TotoNonn/CNC-machine-PCB-desing/README.md

# About project
I'm 700mV. I made this to try to help and to try to understand what happens in a cnc machine when you do all the parts. I started this project when I was in the university. The principal rason to do this is to do PCBs in house, for dont buy something than I can do it. The way is hard because I dont reach the same presition in a handmade machine that the presition in a really good machine made by a manufacturer or made whit super tools.
But is that the challenge, reach that.

## Objetive
Make a CNC machine whit my own tools, learn about everything that I can and help people like me.

Free tools for everyone.

-700mV
