TotoNonn/CNC-machine-PCB-desing/Hardware/Design/PCB-DRV/PCB-DRV.kicad_pcb

## KiCad design Hardware/Design/PCB-DRV/PCB-DRV.kicad_pcb (2026-10-14)

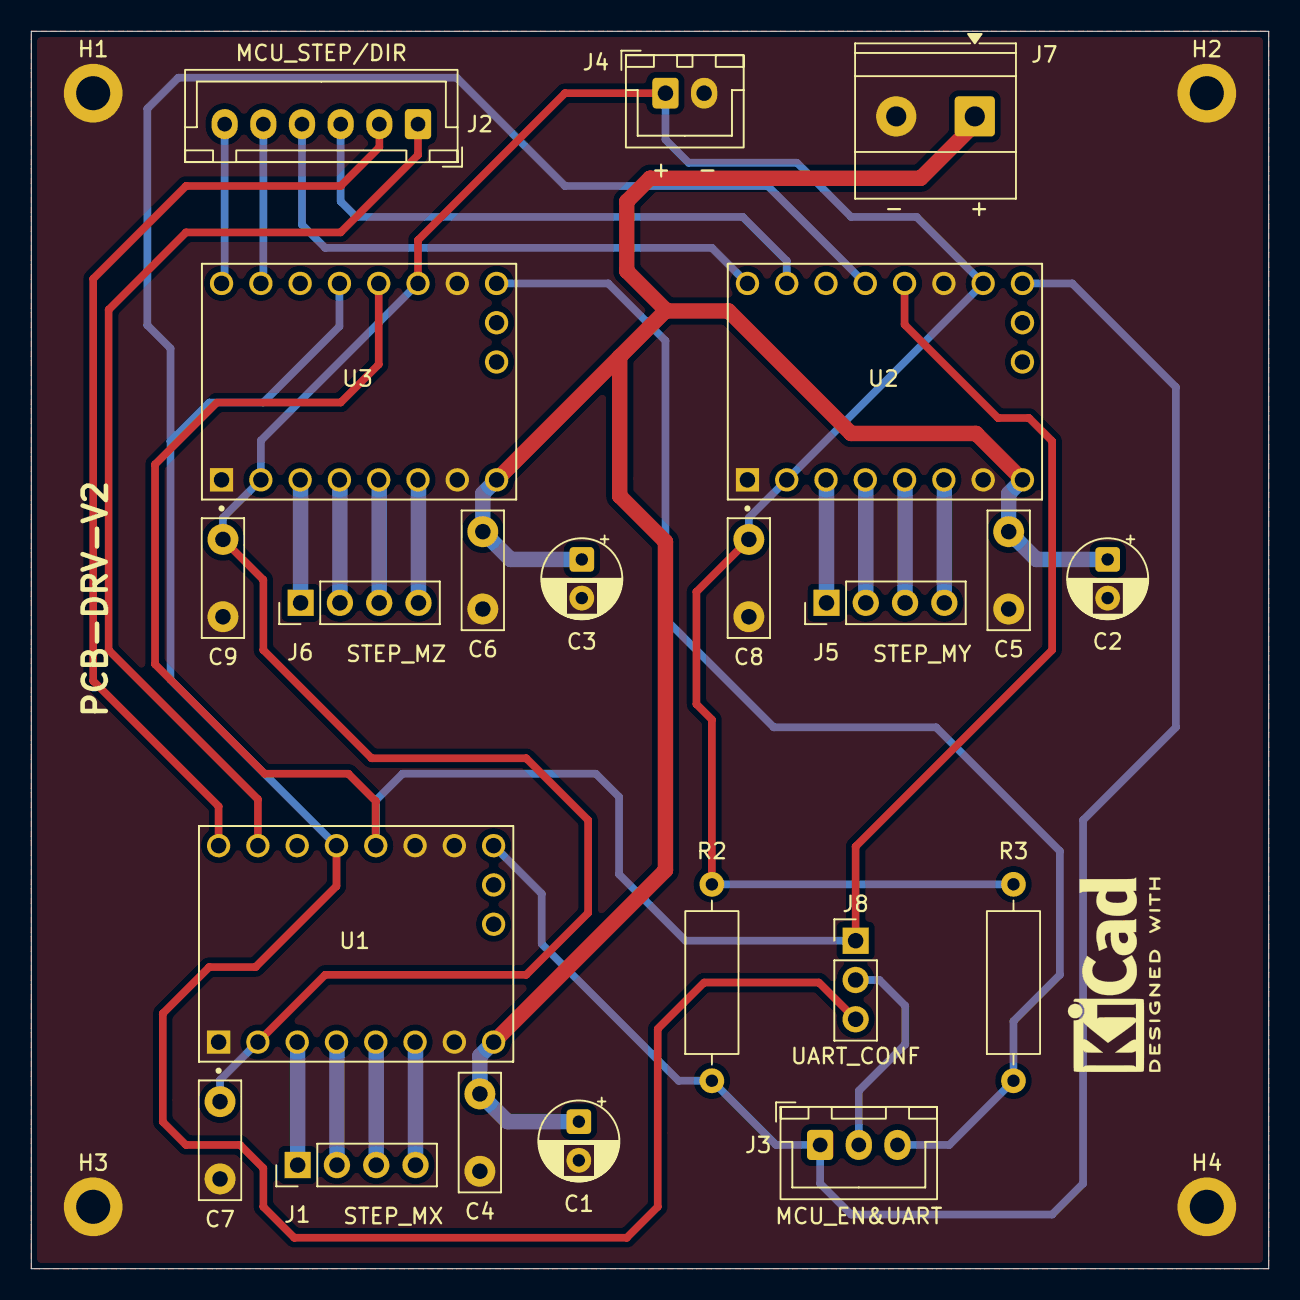
[picture p1: board PCB-DRV.kicad_pcb from above]

Board: 2 copper layers, 80.0 x 80.0 mm, 26 parts (0 on the bottom side), 26 nets.

Parts:
C1, C2, C3: 100uF; CP_Radial_D5.0mm_P2.50mm
C4, C5, C6, C7, C8, C9: 100nF; C_Disc_D7.5mm_W2.5mm_P5.00mm
H1, H2, H3, H4: MountingHole_2.2mm_M2_DIN965_Pad
J1: STEP_MX; PinHeader_1x04_P2.54mm_Vertical
J2: MCU_STEP/DIR; JST_XH_B6B-XH-A_1x06_P2.50mm_Vertical
J3: MCU_EN&UART; JST_XH_B3B-XH-A_1x03_P2.50mm_Vertical
J4: +3.3V; JST_XH_B2B-XH-A_1x02_P2.50mm_Vertical
J5: STEP_MY; PinHeader_1x04_P2.54mm_Vertical
J6: STEP_MZ; PinHeader_1x04_P2.54mm_Vertical
J7: +12V; TerminalBlock_Phoenix_MKDS-1,5-2-5.08_1x02_P5.08mm_Horizont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
J8: UART_CONF; PinHeader_1x03_P2.54mm_Vertical
R2, R3: 10K; R_Axial_DIN0309_L9.0mm_D3.2mm_P12.70mm_Horizontal
U1, U2, U3: TMC2209_SILENTSTEPSTICK; MODULE_TMC2209_SILENTSTEPSTICK

Connections:
+3.3V: C7.1, C8.1, C9.1, J4.1, R2.2, R3.2, U1.2 (VIO), U2.2 (VIO), U2.15 (MS1), U3.2 (VIO), U3.14 (MS2)
+12V: C1.1, C2.1, C3.1, C4.1, C5.1, C6.1, J7.1, U1.8 (VM), U2.8 (VM), U3.8 (VM)
Ax1: J1.2, U1.4 (M1A)
Ax2: J1.1, U1.3 (M1B)
Ay1: J5.2, U2.4 (M1A)
Ay2: J5.1, U2.3 (M1B)
Az1: J6.2, U3.4 (M1A)
Az2: J6.1, U3.3 (M1B)
Bx1: J1.3, U1.5 (M2A)
Bx2: J1.4, U1.6 (M2B)
By1: J5.3, U2.5 (M2A)
By2: J5.4, U2.6 (M2B)
Bz1: J6.3, U3.5 (M2A)
Bz2: J6.4, U3.6 (M2B)
GND: C1.2, C2.2, C3.2, C4.2, C5.2, C6.2, C7.2, C8.2, C9.2, H1.1, H2.2, H3.3, H4.4, J4.2, J7.2, U1.1 (GND), U1.7 (GND), U1.14 (MS2), U1.15 (MS1), U2.1 (GND), U2.7 (GND), U2.14 (MS2), U3.1 (GND), U3.7 (GND), U3.15 (MS1)
GPIO_DIR_1: J2.2, U1.9 (DIR)
GPIO_DIR_2: J2.4, U2.9 (DIR)
GPIO_DIR_3: J2.6, U3.9 (DIR)
GPIO_EN_XY: J3.1, R2.1, U1.16 (~EN), U2.16 (~EN)
GPIO_EN_Z: J3.3, R3.1, U3.16 (~EN)
GPIO_STEP_1: J2.1, U1.10 (STEP)
GPIO_STEP_2: J2.3, U2.10 (STEP)
GPIO_STEP_3: J2.5, U3.10 (STEP)
GPIO_UART: J3.2, J8.2
GPIO_UART_SLNK: J8.3, U1.12 (UART), U2.12 (UART), U3.12 (UART)
GPIO_UART_V985: J8.1, U1.13 (SPRD), U2.13 (SPRD), U3.13 (SPRD)
