TotoNonn/CNC-machine-PCB-desing/Hardware/Design/PCB-HUS/PCB-HUS.kicad_pcb

## KiCad design Hardware/Design/PCB-HUS/PCB-HUS.kicad_pcb (2026-08-30)

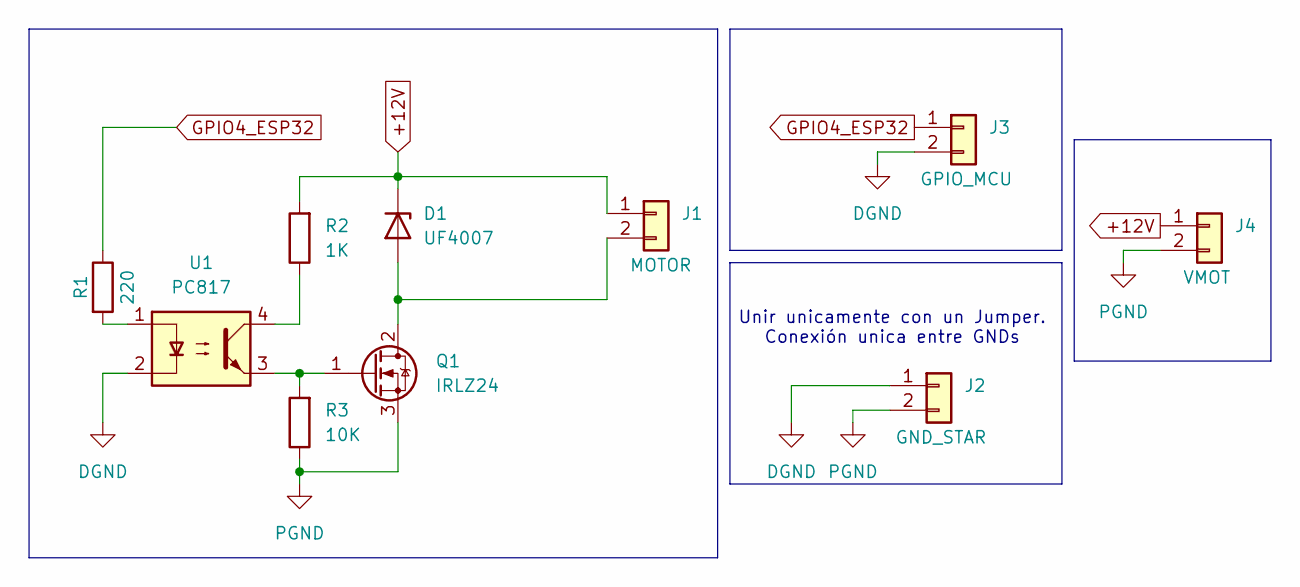
[picture p2: schematic PCB-HUS.kicad_sch]

Parts:
D1: UF4007; D_DO-41_SOD81_P10.16mm_Horizontal
J1: MOTOR; TerminalBlock_Phoenix_MKDS-1,5-2-5.08_1x02_P5.08mm_Horizont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
J2: GND_STAR; PinHeader_1x02_P2.54mm_Vertical
J3: GPIO_MCU; JST_XH_B2B-XH-A_1x02_P2.50mm_Vertical
J4: VMOT; TerminalBlock_Phoenix_MKDS-1,5-2-5.08_1x02_P5.08mm_Horizont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
Q1: IRLZ24; TO-220-3_Vertical
R1: 220; R_Axial_DIN0309_L9.0mm_D3.2mm_P12.70mm_Horizontal
R2: 1K; R_Axial_DIN0309_L9.0mm_D3.2mm_P12.70mm_Horizontal
R3: 10K; R_Axial_DIN0309_L9.0mm_D3.2mm_P12.70mm_Horizontal
U1: PC817; DIP-4_W7.62mm

Connections:
+12V: D1.1 (K), J1.1, J4.1, R2.2
DGND: J2.1, J3.2, U1.2
GPIO4_ESP32: J3.1, R1.1
unnamed: D1.2 (A), J1.2, Q1.2 (D)
unnamed: Q1.1 (G), R3.2, U1.3
unnamed: R1.2, U1.1
unnamed: R2.1, U1.4
PGND: J2.2, J4.2, Q1.3 (S), R3.1

Notes on the sheet:
Unir unicamente con un Jumper. Conexión unica entre GNDs

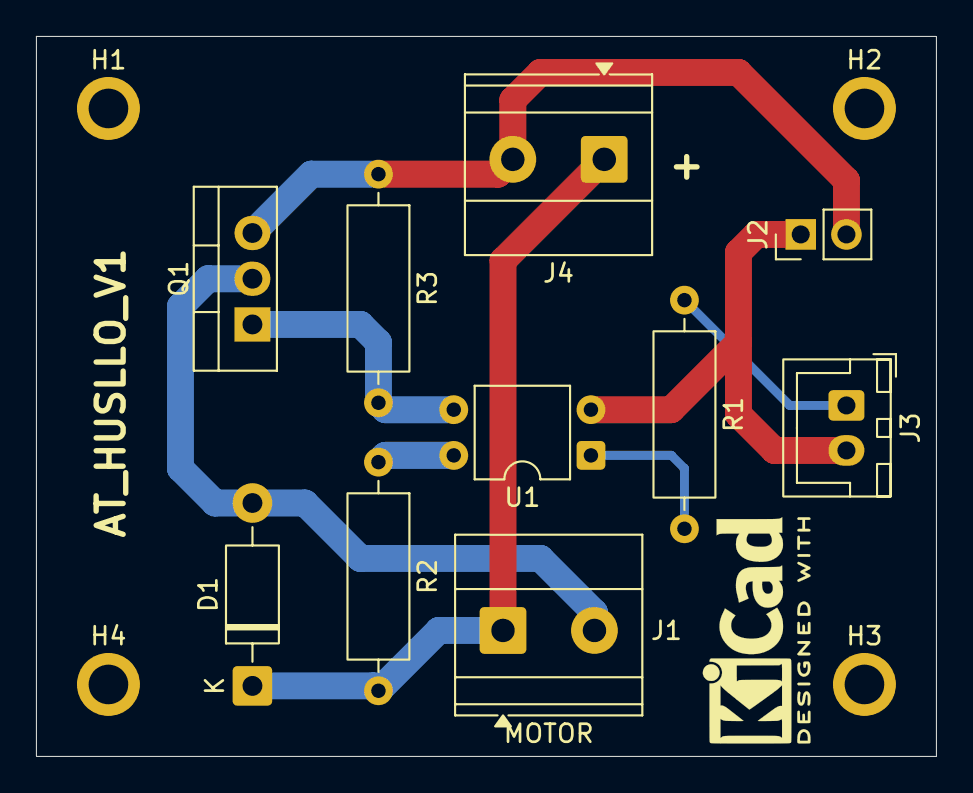
[picture p3: board PCB-HUS.kicad_pcb from above]

Board: 2 copper layers, 50.0 x 40.0 mm, 14 parts (0 on the bottom side), 8 nets.

Other parts of the board:
H1, H2, H3, H4: MountingHole_2.2mm_M2_ISO7380_Pad
