TotoNonn/CNC-machine-PCB-desing/Hardware/Design/PCB-END/PCB-END.kicad_pcb

## KiCad design Hardware/Design/PCB-END/PCB-END.kicad_pcb (2026-08-30)

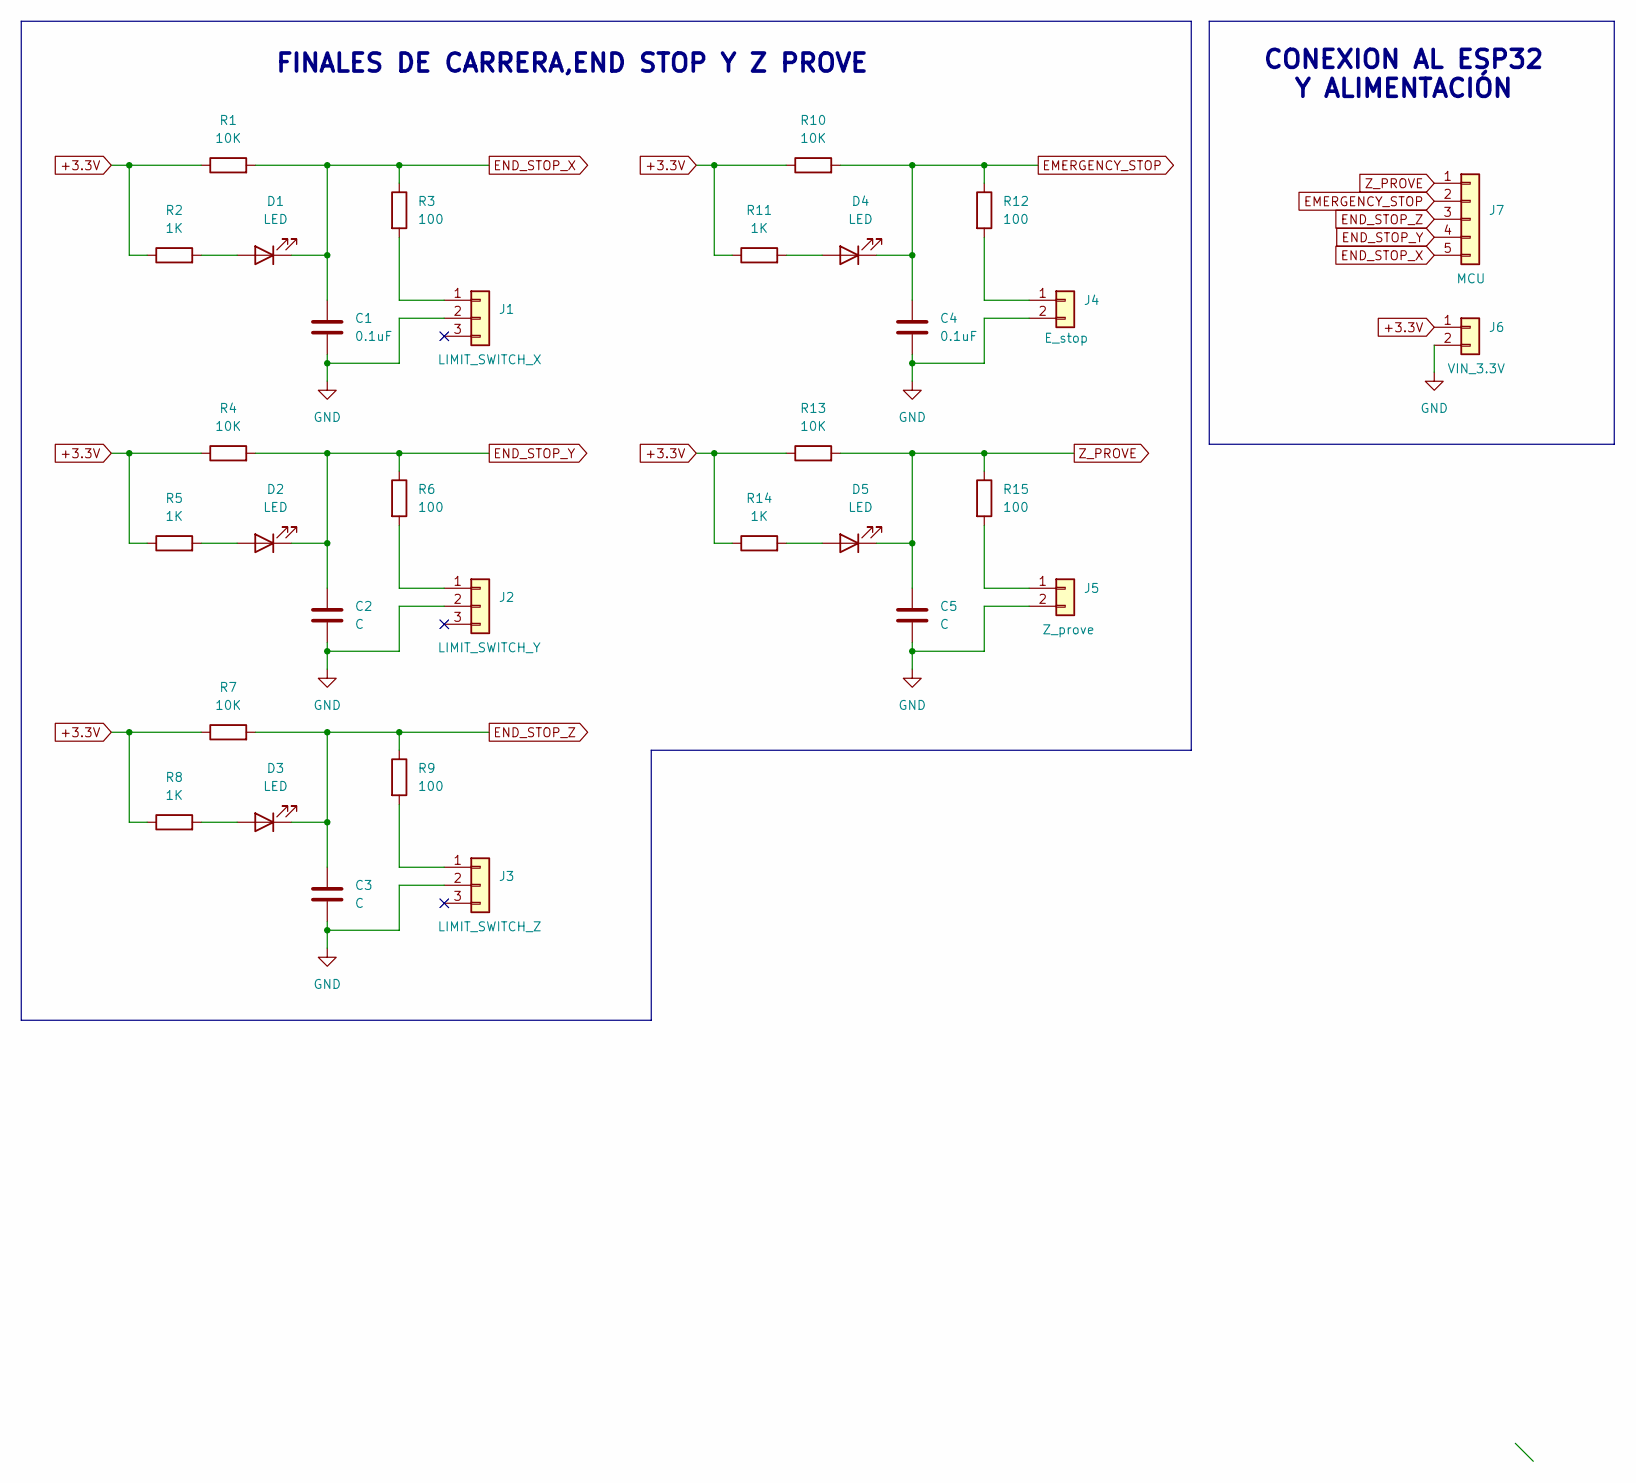
[picture p4: schematic PCB-END.kicad_sch]

Parts:
C1, C4: 0.1uF; C_Disc_D4.3mm_W1.9mm_P5.00mm
C2, C3, C5: C; C_Disc_D4.3mm_W1.9mm_P5.00mm
D1, D2, D3, D4, D5: LED; LED_D3.0mm
J1: LIMIT_SWITCH_X; JST_XH_B3B-XH-A_1x03_P2.50mm_Vertical
J2: LIMIT_SWITCH_Y; JST_XH_B3B-XH-A_1x03_P2.50mm_Vertical
J3: LIMIT_SWITCH_Z; JST_XH_B3B-XH-A_1x03_P2.50mm_Vertical
J4: E_stop; JST_XH_B2B-XH-A_1x02_P2.50mm_Vertical
J5: Z_prove; JST_XH_B2B-XH-A_1x02_P2.50mm_Vertical
J6: VIN_3.3V; JST_XH_B2B-XH-A_1x02_P2.50mm_Vertical
J7: MCU; JST_XH_B5B-XH-A_1x05_P2.50mm_Vertical
R1, R4, R7, R10, R13: 10K; R_Axial_DIN0309_L9.0mm_D3.2mm_P12.70mm_Horizontal
R2, R5, R8, R11, R14: 1K; R_Axial_DIN0309_L9.0mm_D3.2mm_P12.70mm_Horizontal
R3, R6, R9, R12, R15: 100; R_Axial_DIN0309_L9.0mm_D3.2mm_P12.70mm_Horizontal

Connections:
+3.3V: J6.1, R1.1, R2.1, R4.1, R5.1, R7.1, R8.1, R10.1, R11.1, R13.1, R14.1
EMERGENCY_STOP: C4.1, D4.1 (K), J7.2, R10.2, R12.1
END_STOP_X: C1.1, D1.1 (K), J7.5, R1.2, R3.1
END_STOP_Y: C2.1, D2.1 (K), J7.4, R4.2, R6.1
END_STOP_Z: C3.1, D3.1 (K), J7.3, R7.2, R9.1
GND: C1.2, C2.2, C3.2, C4.2, C5.2, J1.2, J2.2, J3.2, J4.2, J5.2, J6.2; also elsewhere on the board
unnamed: D1.2 (A), R2.2
unnamed: D2.2 (A), R5.2
unnamed: D3.2 (A), R8.2
unnamed: D4.2 (A), R11.2
unnamed: D5.2 (A), R14.2
unnamed: J1.1, R3.2
unnamed: J2.1, R6.2
unnamed: J3.1, R9.2
unnamed: J4.1, R12.2
unnamed: J5.1, R15.2
Z_PROVE: C5.1, D5.1 (K), J7.1, R13.2, R15.1

Notes on the sheet:
CONEXION AL ESP32 Y ALIMENTACIÓN
FINALES DE CARRERA,END STOP Y Z PROVE

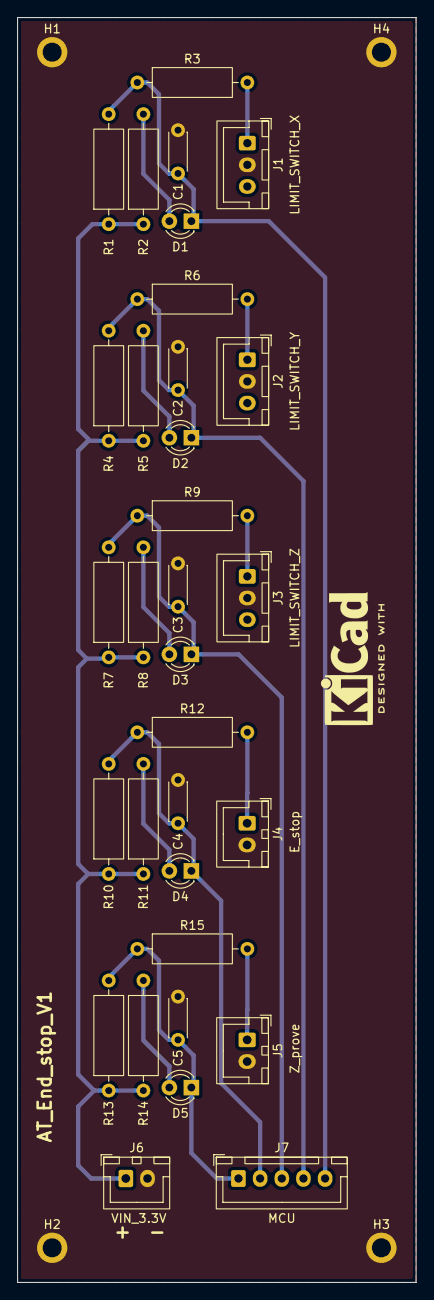
[picture p5: board PCB-END.kicad_pcb from above]

Board: 2 copper layers, 46.0 x 146.0 mm, 36 parts (0 on the bottom side), 17 nets.

Other parts of the board:
H1, H2, H3, H4: MountingHole_2.2mm_M2_ISO7380_Pad

Their connections:
GND: H1.1, H2.2, H3.3, H4.4; also elsewhere on the board
