TotoNonn/CNC-machine-PCB-desing/Hardware/Design/PCB-MCU/PCB-MCU.kicad_pcb

## KiCad design Hardware/Design/PCB-MCU/PCB-MCU.kicad_pcb (2026-08-30)

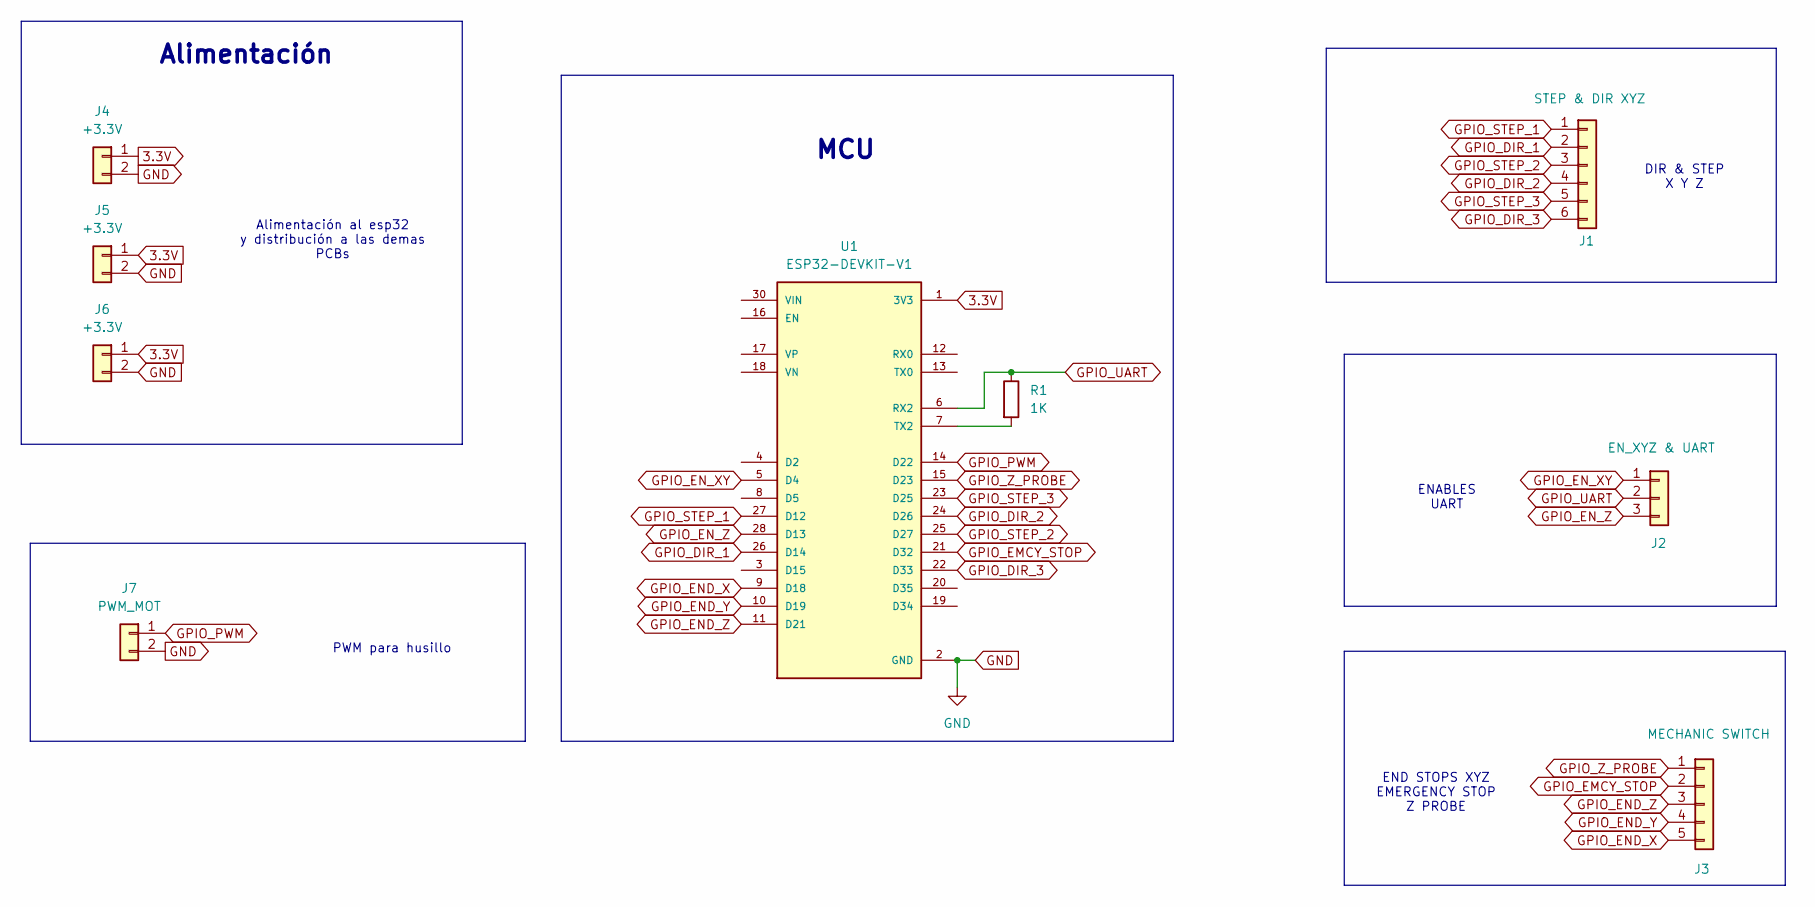
[picture p6: schematic PCB-MCU.kicad_sch]

Parts:
J1: STEP & DIR XYZ; JST_XH_B6B-XH-A_1x06_P2.50mm_Vertical
J2: EN_XYZ & UART; JST_XH_B3B-XH-A_1x03_P2.50mm_Vertical
J3: MECHANIC SWITCH; JST_XH_B5B-XH-A_1x05_P2.50mm_Vertical
J4, J5, J6: +3.3V; JST_XH_B2B-XH-A_1x02_P2.50mm_Vertical
J7: PWM_MOT; JST_XH_B2B-XH-A_1x02_P2.50mm_Vertical
R1: 1K; R_Axial_DIN0207_L6.3mm_D2.5mm_P7.62mm_Horizontal
U1: ESP32-DEVKIT-V1; MODULE_ESP32_DEVKIT_V1; PARTREV N/A

Connections:
3.3V: J4.1, J5.1, J6.1, U1.1 (3V3)
GND: J4.2, J5.2, J6.2, J7.2, U1.2 (GND), U1.29 (GND)
GPIO_DIR_1: J1.2, U1.26 (D14)
GPIO_DIR_2: J1.4, U1.24 (D26)
GPIO_DIR_3: J1.6, U1.22 (D33)
GPIO_EMCY_STOP: J3.2, U1.21 (D32)
GPIO_END_X: J3.5, U1.9 (D18)
GPIO_END_Y: J3.4, U1.10 (D19)
GPIO_END_Z: J3.3, U1.11 (D21)
GPIO_EN_XY: J2.1, U1.5 (D4)
GPIO_EN_Z: J2.3, U1.28 (D13)
GPIO_PWM: J7.1, U1.14 (D22)
GPIO_STEP_1: J1.1, U1.27 (D12)
GPIO_STEP_2: J1.3, U1.25 (D27)
GPIO_STEP_3: J1.5, U1.23 (D25)
GPIO_UART: J2.2, R1.1, U1.6 (RX2)
GPIO_Z_PROBE: J3.1, U1.15 (D23)
unnamed: R1.2, U1.7 (TX2)

Notes on the sheet:
MCU
Alimentación
ENABLES UART
DIR & STEP X Y Z
Alimentación al esp32 y distribución a las demas PCBs
END STOPS XYZ EMERGENCY STOP Z PROBE
PWM para husillo

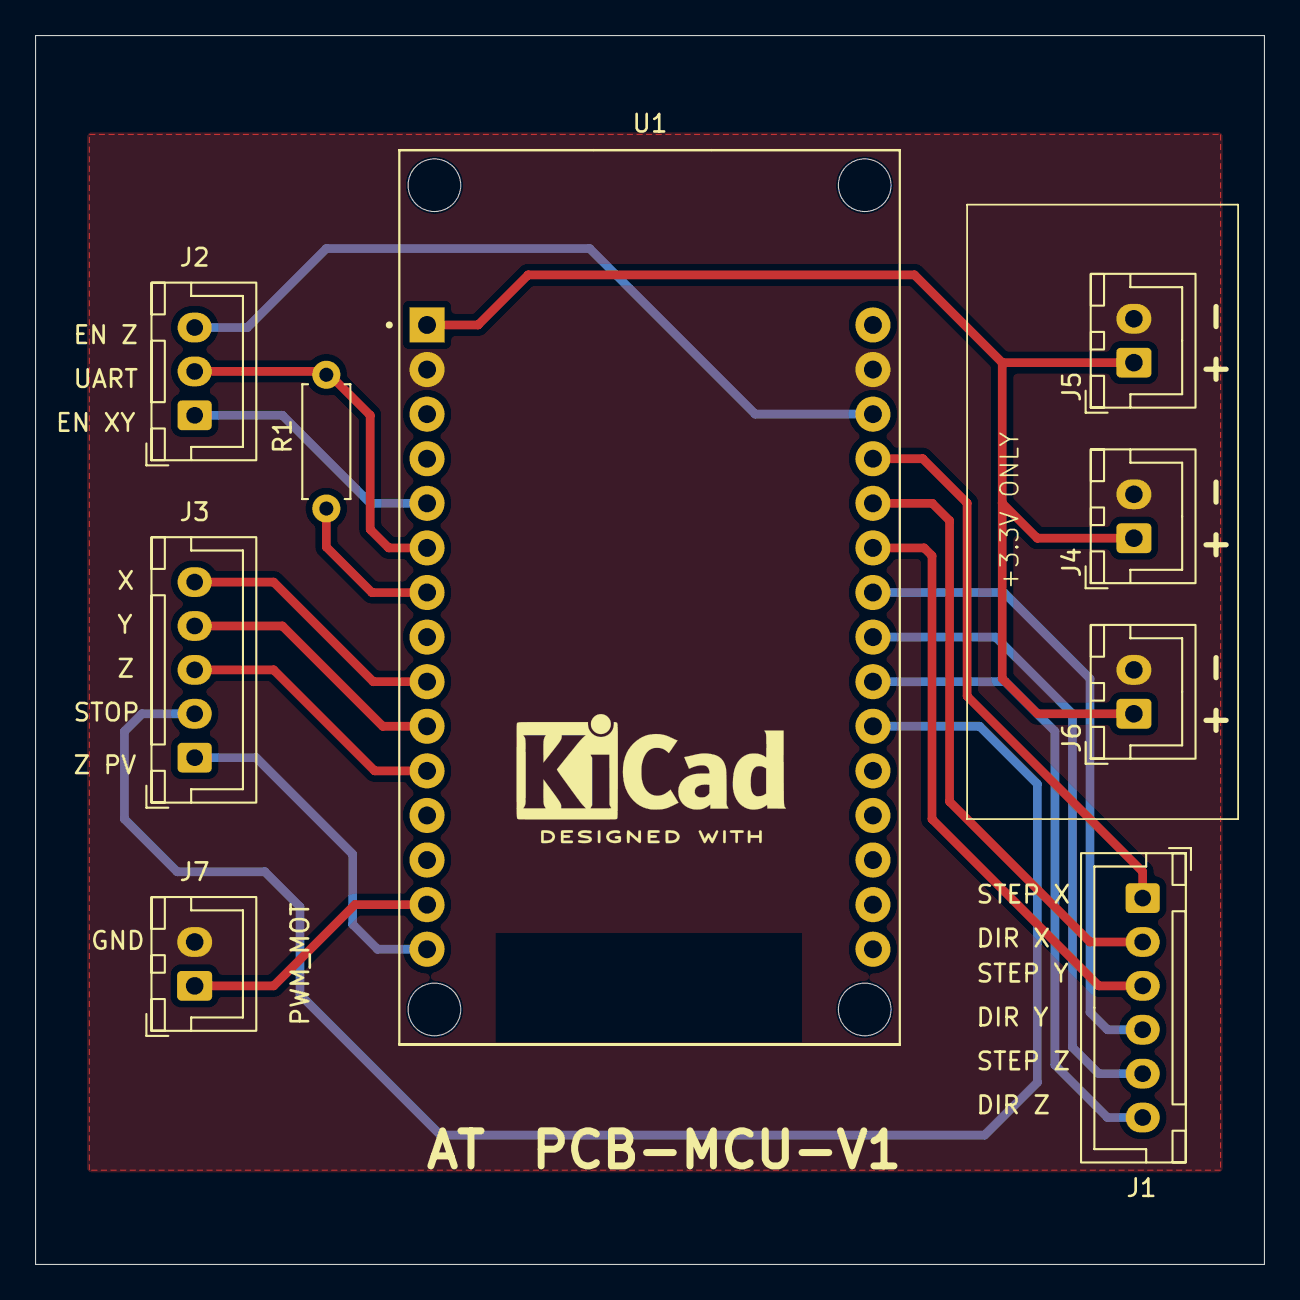
[picture p7: board PCB-MCU.kicad_pcb from above]

Board: 2 copper layers, 70.0 x 70.0 mm, 9 parts (0 on the bottom side), 18 nets.
