TotoNonn/CNC-machine-PCB-desing/(commit log)

2026-08-30 Docs: Registro de falla UART en placa PCB-DRV original
    [PCB-DRV.kicad_pcb, PCB-DRV.kicad_sch, PCB-END.kicad_pcb, PCB-END.kicad_sch, PCB-HUS.kicad_pcb, PCB-HUS.kicad_sch, PCB-MCU.kicad_pcb, PCB-MCU.kicad_sch]
2026-09-01 FIX del pin 12 al pin 13 para driver V985, movi la alimentación a separada, 12V y 3.3V, hice un selector de driver o tipo de driver
    [PCB-DRV.kicad_pcb, PCB-DRV.kicad_sch]
2026-10-14 Actualicé la PCB de drivers para que se puedan cargar los dos tipos de drivers TMC 2209, el de silentstepstick y el chino
    [PCB-DRV.kicad_pcb]
2026-10-14 Actualicé el errata para que tenga lo que le hice a la nueva versión de la PCB de los drivers
2026-11-01 reubicación del errata. Cambio en el contenido de readme. Agregue el Firmware de fluid NC
    [PCB-HUS.kicad_sch]
